Fattoresaimon/I2CEncoderMini/Hardware/BOM/Bill of Materials-EncoderI2C_Mini.xlsx

Description | Designator | Value | Footprint | MouserCode | PartNumber
Capacitor | C1 | 100n | C0402 | 603-CC402KRX5R8BB104 | GRM155R61C104KA88D
Capacitor | C2 | 4u7 | C0805 | 603-CC805ZKY5V7BB475 | CC0805ZKY5V7BB475
Capacitor | C3 | 47n | C0402 | 81-GCM155R71E473KA5D | GCM155R71E473KA55D
Capacitor | C4 | 47n | C0402 | 81-GCM155R71E473KA5D | GCM155R71E473KA55D
Ferrite Bead | L1 | 600R@100MHz | L0402 | 963-BK1005HS601-T | BK1005HS601-T
Resistor | R1 | 10k | R0402 | 603-RC0402FR-0710KL | RC0402FR-0710KL
Resistor | R2 | 10k | R0402 | 603-RC0402FR-0710KL | RC0402FR-0710KL
Resistor | R3 | 10k | R0402 | 603-RC0402FR-0710KL | RC0402FR-0710KL
Resistor | R4 | 10k | R0402 | 603-RC0402FR-0710KL | RC0402FR-0710KL
Microcontrollori a 8 bit - MCU 20MHz, 4KB, SOIC8, Ind 125C, Green, T&R | U1 |  | 8S1_L | 579-ATTINY402-SSFR | ATTINY402-SSFR
