Fattoresaimon/I2CEncoderMini/Hardware/STEP/EncoderI2C_Mini.step

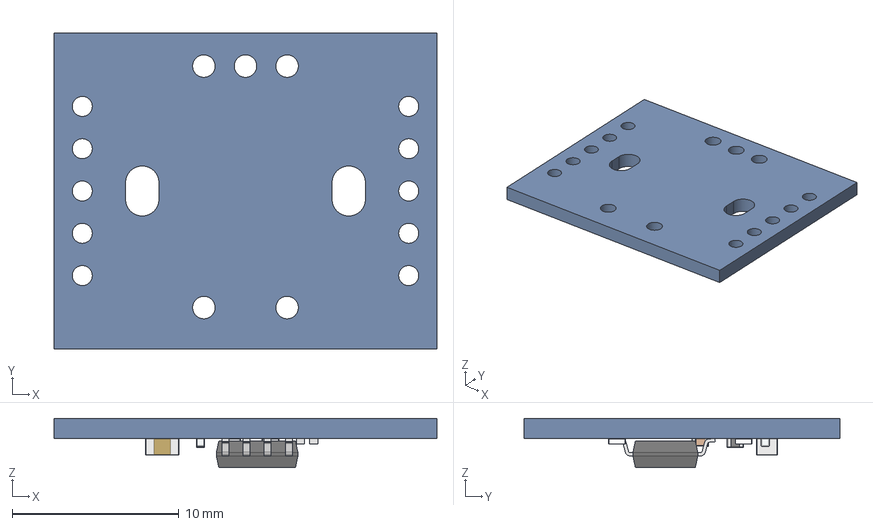
[picture p11: CAD file, 2020-09-24]
Hardware/STEP/EncoderI2C_Mini.step
23.0 x 19.0 x 2.95 mm
User_Library-V0402HD_K_X_F6rper_1
User_Library-V0402HD_Anschl_X_FCsse_1
User_Library-Capacitor_0402 x 3
SOIC-8
User_Library-R_0402 x 4
User_Library-CAPC2013X10
