Fattoresaimon/I2CEncoderMini/(list of files, cad)

Other CAD files:
Hardware/AutoCAD PCB/EncoderI2C_Mini.DWG
