Fattoresaimon/I2CEncoderMini/(threads)

Thread 1 (2020-04-11):

Capacitor discharge resistor

ilium007, 2020-04-11:
Shouldn't there be a small resistor in series with the capacitor and the encoder contacts to prevent the cap short circuit to GND?

Fattoresaimon, 2020-04-11:
Hello, yes you are right!
I know that my filter design it's not very good... That was a quick and dirty solution, my original plan was to don't put any filter and do all in FW. I'm still work on it...

Thread 2 (2020-06-22):

Pin strip spacing.

Hugh3226, 2020-06-22:
It's a real shame the pin spacing is not the same on the V2.1 encoder and the min encoder.

Pin spacing is 19.6mm on the mini and 20.9mm on the v2.1           (estimated from the gerber files)

This makes them almost incompatible.

Regards
Hugh

Thread 3 (2020-10-16):

Mini Encoder not found.

psy1261, 2020-10-16:
I bought several of the mini boards a few months ago but just now got to try them out.  I am running the Change_Address program but can never find the encoder.  I have tried three diffrent boards using a Tinsey 3.2, NodeMCU v2 ESP8266 and a ATmega328P. I have verified my setup each time using an MCP23017 wired for address 0x27, the MCP chip always shows up but never the mini. Any thoughts or suggestions?

Fattoresaimon, 2020-10-16:
Hello,
Did you checked the if there is the pull-up resistor on the I2C bus?
With the default address it works?
Thank you!

psy1261, 2020-10-16:
Yes, as I said I confirmed via two other devices. My apologies, what is the default address? 0x20?

I used 10K pull-up resisters to connect +5v to SCL and +5v to SDA.

I used three diffrent sketches to find i2c devices all three found the other two devices but never the mini encoder. I also ran the Change_Address sketch but it never finds the min-encoder. I am lost.

Paul

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

Fattoresaimon, 2020-10-16:
yes the default address is 0x20
But if the other devices are found the problem are not the pull-up resistors.
check the connection please, and send me a email with the order number.

psy1261, 2020-10-16:
I installed the header pins and hooked up one of the other i2c devices… the two devices are still registering but the mini encoder is not.

Order number was 203512 on July 11 2020.

Any other troubleshooting steps?  Any advantage to changing wire speed? Using the internal pull-ups instead of external? These mini boards would solve several problems I am facing if I can get them to work.

Paul

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

Fattoresaimon, 2020-10-17:
Hello,
Did you tried alle the boards that you bought?
Did you tried the example project?
Did you verified if there is an address conflict in the i2c bus

Try only one board alone without the other device in the same i2c bus.

psy1261, 2020-10-17:
Howdy

I setup an ATmega328P with an Ardweeny programing backpack, external 10K pull-up resisters and only the mini encoder board. I did make one small change to your Change_Address.ino sketch:

void Search(void) {
  uint8_t i, error;
  Serial.println("Scanning....");
  for (i = 0; i < 0x80; i++ )  {
    Wire.beginTransmission(i);
    error = Wire.endTransmission();

    if (error == 0)    {
      Encoder.address = i;
     // if (Encoder.readIDCode() == 0x39) {				// Comment out his line
        Serial.print("I2C Encoder mini found at ");
        Serial.print(Encoder.address);
        Serial.print(" ( ");
        PrintHEX(Encoder.address);
        Serial.print(" )");
        Serial.println(" !!");
      //}											// Comment out his line
    }

  }
}

This allowed be to substitute and i2c OLED display to make sure I have the hardware setup correctly.  With the above change I got the following printout:
**** I2C Encoder Address changer! ****
All the devices must have different address!
Avaiable commands:
  S: for searching the I2C encoder mini
  0xXX or XXX: Address of the target device in hex or decimal

Scanning....
I2C Encoder mini found at 60 ( 0x3C ) !!   <<<< Correctly identifies the i2c OLED display.

At this point, I soldered headers on all the remaining bards. To test I put each new board in circuit, presed the rest button on the Ardweeny/ATmega328P and then entered “S” on the program. I left in the two comments above int the code. I tested all boards with the same results, the mini encoders were not found.  I have to be missing something.

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

psy1261, 2020-10-17:
Well I feel stupid.

I thought the pinout was SCL SDA Open Pin + -
Im fact it is NT SCL SDA + -

It works now. What in the NT pin for?

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

Fattoresaimon, 2020-10-17:
😆
Good that you made to work!
Well there is no NT pin, it's the INT pin.
It's the interrupt output pin, it used to sense when the encoder is rotated without continually pooling the board.
Please check out the datasheet: https://github.com/Fattoresaimon/I2CEncoderMini/blob/master/I2CEncoderMini_v1.2.pdf

psy1261, 2020-10-17:
All working as expected! Thank you for all the help!!!

Closed 2020-10-17.

Thread 4 (2021-01-18):

Using the Atmel Project and loading it into a device under debug immediately bricks the device

rowifi, 2021-01-18:
I've tried two devices, and bricked both. Presumably the project as is must disable the UPDI pin feature in order to use the pin as an interrupt out. Maybe the devices are now functioning as i2c encoders, but I can't check that right now.
If I'm correct, where does that occur in the code? I'd like to prevent it to verify my IDE and programmer is set up correctly.

I didn't think the UPDI could be locked out without setting a fuse, and I didn't think fuses were set by loading and running code in debug.

Fattoresaimon, 2021-01-18:
Hello,
The UPDI pins is used as a GPIO pin in my code, it's configure in the fuse:
`#define f_SYSCFG0  0xF0 //GPIO MODE`
If i remember correctly if you set it as a GPIO, even during the debug, it disable the UPDI and you can't debug.
If the pin is set to GPIO your programmer have to give a 12V pulse in order to revert the pin to the UPDI.
I'm using the pickit4 and it to automatically.
But i remember while i was developing the project, that sometime the ATtiny402 was looking bricked.
The solution was to erase the entire chip plus the UserSignature.
In the Atmel studio you can do like that: Tools -> Device Programming -> memories
Under Device choose the two type of memory.

Thread 5 (2021-01-22):

INT pin not working

nburobotics, 2021-01-22:
I assembled 4 pieces of I2CEncoderMini_V1.1 and uploaded the HEX file directly. I've got everything working except the INT pin.
I'm using the Basic_with_Callbacks sketch. I'm trying to read the configuration and it is:
interrupt config is 255
ID code is 57
version is 17
It seems to me that the INT pin never goes LOW regardless of "i2cEncoderMiniLib::IPUP_ENABLE" or IPUP_DISABLE.
Is there something else around the proper use of the INT?

Fattoresaimon, 2021-01-22:
Hello,
The int pin is also the UPDI pin used for programming.
You have also to flash the fuse bit in order to change the UPDI pin to GPIO.
In atmel studio there is a checkbox where you can select that field.
If you used some DYI programmer probably it will not work, but i'm not sure.
I suggest you to use the pickit4 and use directly Atmel studio by loading the elf file.

nburobotics, 2021-01-26:
Hello,
Thank you Fattoresaimon for your prompt response. I liked very much your encoder solution.
I'm working in Linux and I don't have pickit4... I want to share the following solution which works, It uses avrdude (the same used by Arduino to upload):

for test pruposes (UPDI enabled)
<PATH TO>avrdude -C <PATH TO>avrdude.conf -v -p attiny402 -c jtag2updi -P /dev/ttyUSB0 -Ufuse2:w:0x02:m -Ufuse6:w:0x04:m -Ufuse8:w:0x00:m -Uflash:w:I2CEncoderMini.hex

for "production" purposes (GPIO enabled, UPDI locked)
<PATH TO>avrdude -C <PATH TO>avrdude.conf -v -p attiny402 -c jtag2updi -P /dev/ttyUSB0 -Ufuse2:w:0x02:m -Ufuse5:w:0xc1:m -Ufuse6:w:0x04:m -Ufuse8:w:0x00:m -Ulock:w:0x00:m -Uflash:w:I2CEncoderMini.hex

Fattoresaimon, 2021-01-26:
Hello,
So at the end was the fuse bit right?
Pay attention that in case of UPDI disabled you need to give the 12V pulse to revert back to UPDI.
Thank you for sharing your solution! i think it will be useful for some other user.
Thank you,
Simone

speedcrafter442, 2021-06-22:
Hello,
I tried the suggestion from nburobotics but I can't find the EncoderMini via i2c after the flash.

Result from flash:
C:\avrdude>avrdude -v -p attiny402 -c jtag2updi -P com1 -Ufuse2:w:0x02:m -Ufuse6:w:0x04:m -Ufuse8:w:0x00:m -Uflash:w:I2CEncoderMini.hex

avrdude: Version 6.3, compiled on Feb 17 2016 at 09:25:53
         Copyright (c) 2000-2005 Brian Dean, http://www.bdmicro.com/
         Copyright (c) 2007-2014 Joerg Wunsch

         System wide configuration file is "C:\avrdude\avrdude.conf"

         Using Port                    : com1
         Using Programmer              : jtag2updi
JTAG ICE mkII sign-on message:
Communications protocol version: 1
M_MCU:
  boot-loader FW version:        1
  firmware version:              6.00
  hardware version:              1
S_MCU:
  boot-loader FW version:        1
  firmware version:              6.00
  hardware version:              1
Serial number:                   00:00:00:00:00:00
Device ID:                       JTAGICE mkII
         AVR Part                      : ATtiny402
         Chip Erase delay              : 0 us
         PAGEL                         : P00
         BS2                           : P00
         RESET disposition             : dedicated
         RETRY pulse                   : SCK
         serial program mode           : yes
         parallel program mode         : yes
         Timeout                       : 0
         StabDelay                     : 0
         CmdexeDelay                   : 0
         SyncLoops                     : 0
         ByteDelay                     : 0
         PollIndex                     : 0
         PollValue                     : 0x00
         Memory Detail                 :

                                  Block Poll               Page                       Polled
           Memory Type Mode Delay Size  Indx Paged  Size   Size #Pages MinW  MaxW   ReadBack
           ----------- ---- ----- ----- ---- ------ ------ ---- ------ ----- ----- ---------
           signature      0     0     0    0 no          3    0      0     0     0 0x00 0x00
           prodsig        0     0     0    0 no         61   61      0     0     0 0x00 0x00
           fuses          0     0     0    0 no          9    0      0     0     0 0x00 0x00
           fuse0          0     0     0    0 no          1    0      0     0     0 0x00 0x00
           fuse1          0     0     0    0 no          1    0      0     0     0 0x00 0x00
           fuse2          0     0     0    0 no          1    0      0     0     0 0x00 0x00
           fuse4          0     0     0    0 no          1    0      0     0     0 0x00 0x00
           fuse5          0     0     0    0 no          1    0      0     0     0 0x00 0x00
           fuse6          0     0     0    0 no          1    0      0     0     0 0x00 0x00
           fuse7          0     0     0    0 no          1    0      0     0     0 0x00 0x00
           fuse8          0     0     0    0 no          1    0      0     0     0 0x00 0x00
           lock           0     0     0    0 no          1    0      0     0     0 0x00 0x00
           data           0     0     0    0 no          0    0      0     0     0 0x00 0x00
           usersig        0     0     0    0 no         32   32      0     0     0 0x00 0x00
           flash          0     0     0    0 no       4096   64      0     0     0 0x00 0x00
           eeprom         0     0     0    0 no        128   32      0     0     0 0x00 0x00

         Programmer Type : JTAGMKII_PDI
         Description     : JTAGv2 to UPDI bridge
         M_MCU hardware version: 1
         M_MCU firmware version: 6.00
         S_MCU hardware version: 1
         S_MCU firmware version: 6.00
         Serial number:          00:00:00:00:00:00
         Vtarget         : 5.0 V

avrdude: AVR device initialized and ready to accept instructions

Reading | ################################################## | 100% 0.16s

avrdude: Device signature = 0x1e9227 (probably t402)
avrdude: NOTE: Programmer supports page erase for Xmega devices.
         Each page will be erased before programming it, but no chip erase is performed.
         To disable page erases, specify the -D option; for a chip-erase, use the -e option.
avrdude: reading input file "0x02"
avrdude: writing fuse2 (1 bytes):

Writing | ################################################## | 100% 0.01s

avrdude: 1 bytes of fuse2 written
avrdude: verifying fuse2 memory against 0x02:
avrdude: load data fuse2 data from input file 0x02:
avrdude: input file 0x02 contains 1 bytes
avrdude: reading on-chip fuse2 data:

Reading | ################################################## | 100% 0.01s

avrdude: verifying ...
avrdude: 1 bytes of fuse2 verified
avrdude: reading input file "0x04"
avrdude: writing fuse6 (1 bytes):

Writing | ################################################## | 100% 0.01s

avrdude: 1 bytes of fuse6 written
avrdude: verifying fuse6 memory against 0x04:
avrdude: load data fuse6 data from input file 0x04:
avrdude: input file 0x04 contains 1 bytes
avrdude: reading on-chip fuse6 data:

Reading | ################################################## | 100% 0.01s

avrdude: verifying ...
avrdude: 1 bytes of fuse6 verified
avrdude: reading input file "0x00"
avrdude: writing fuse8 (1 bytes):

Writing | ################################################## | 100% 0.01s

avrdude: 1 bytes of fuse8 written
avrdude: verifying fuse8 memory against 0x00:
avrdude: load data fuse8 data from input file 0x00:
avrdude: input file 0x00 contains 1 bytes
avrdude: reading on-chip fuse8 data:

Reading | ################################################## | 100% 0.01s

avrdude: verifying ...
avrdude: 1 bytes of fuse8 verified
avrdude: reading input file "I2CEncoderMini.hex"
avrdude: input file I2CEncoderMini.hex auto detected as raw binary
avrdude: writing flash (4096 bytes):

Writing | ################################################## | 100% 2.05s

avrdude: 4096 bytes of flash written
avrdude: verifying flash memory against I2CEncoderMini.hex:
avrdude: load data flash data from input file I2CEncoderMini.hex:
avrdude: input file I2CEncoderMini.hex auto detected as raw binary
avrdude: input file I2CEncoderMini.hex contains 4096 bytes
avrdude: reading on-chip flash data:

Reading | ################################################## | 100% 1.35s

avrdude: verifying ...
avrdude: 4096 bytes of flash verified

avrdude done.  Thank you.
