Fattoresaimon/I2CEncoderMini/Hardware/EncoderI2C_Mini.PDF

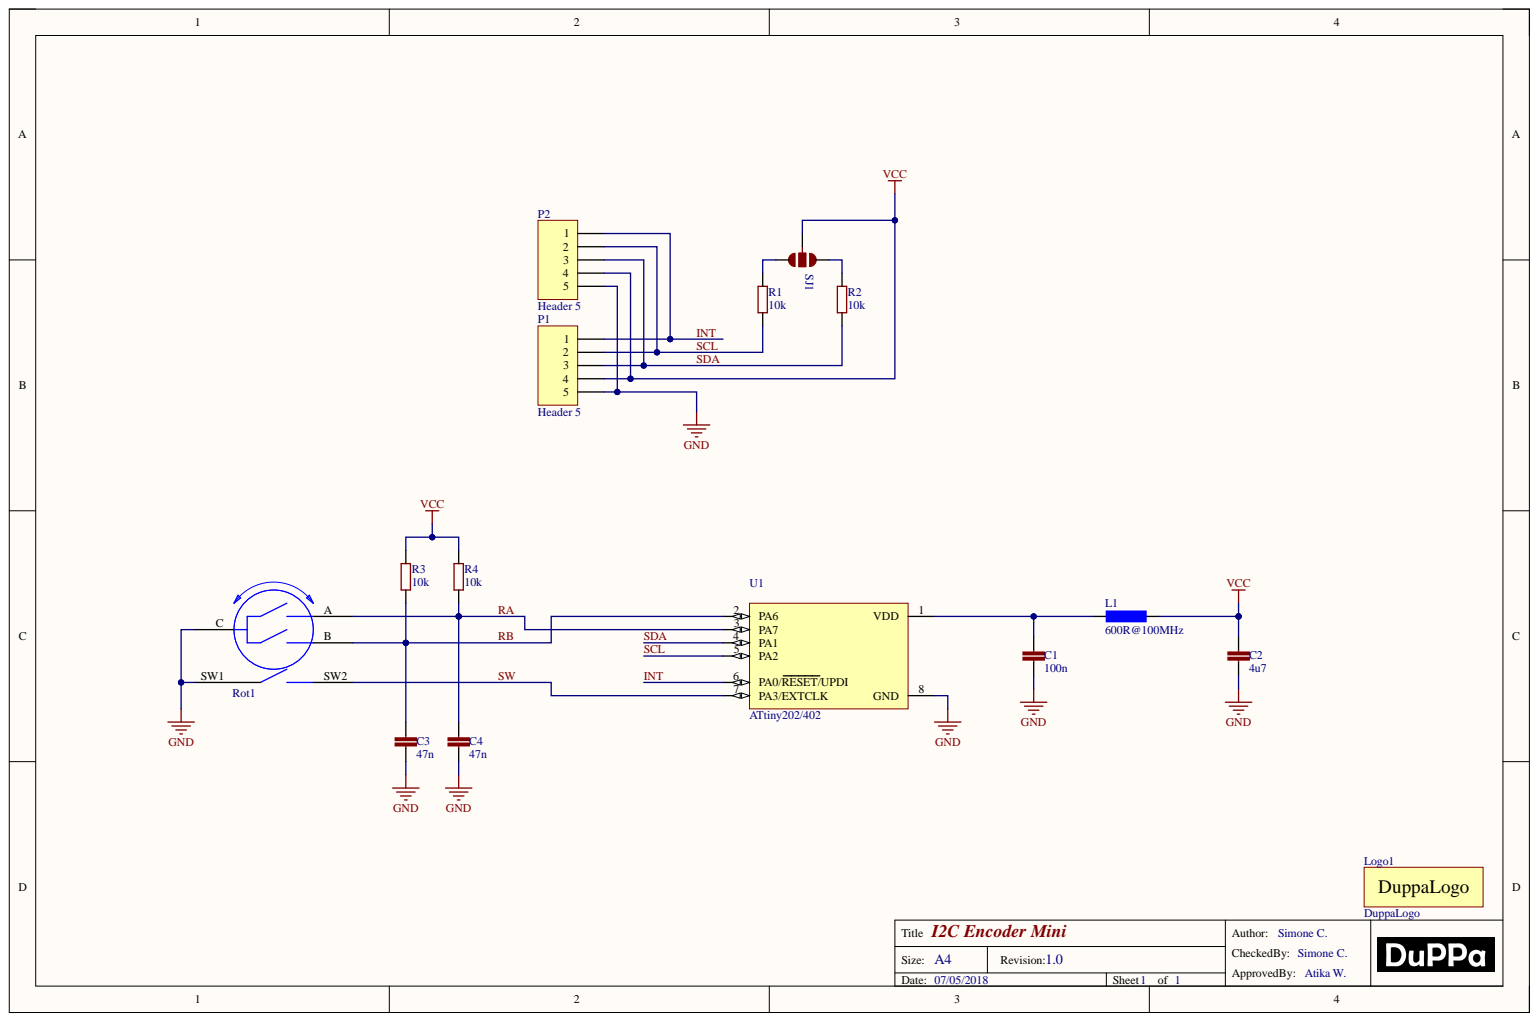
[picture p12: page 1]

SCL
SDA

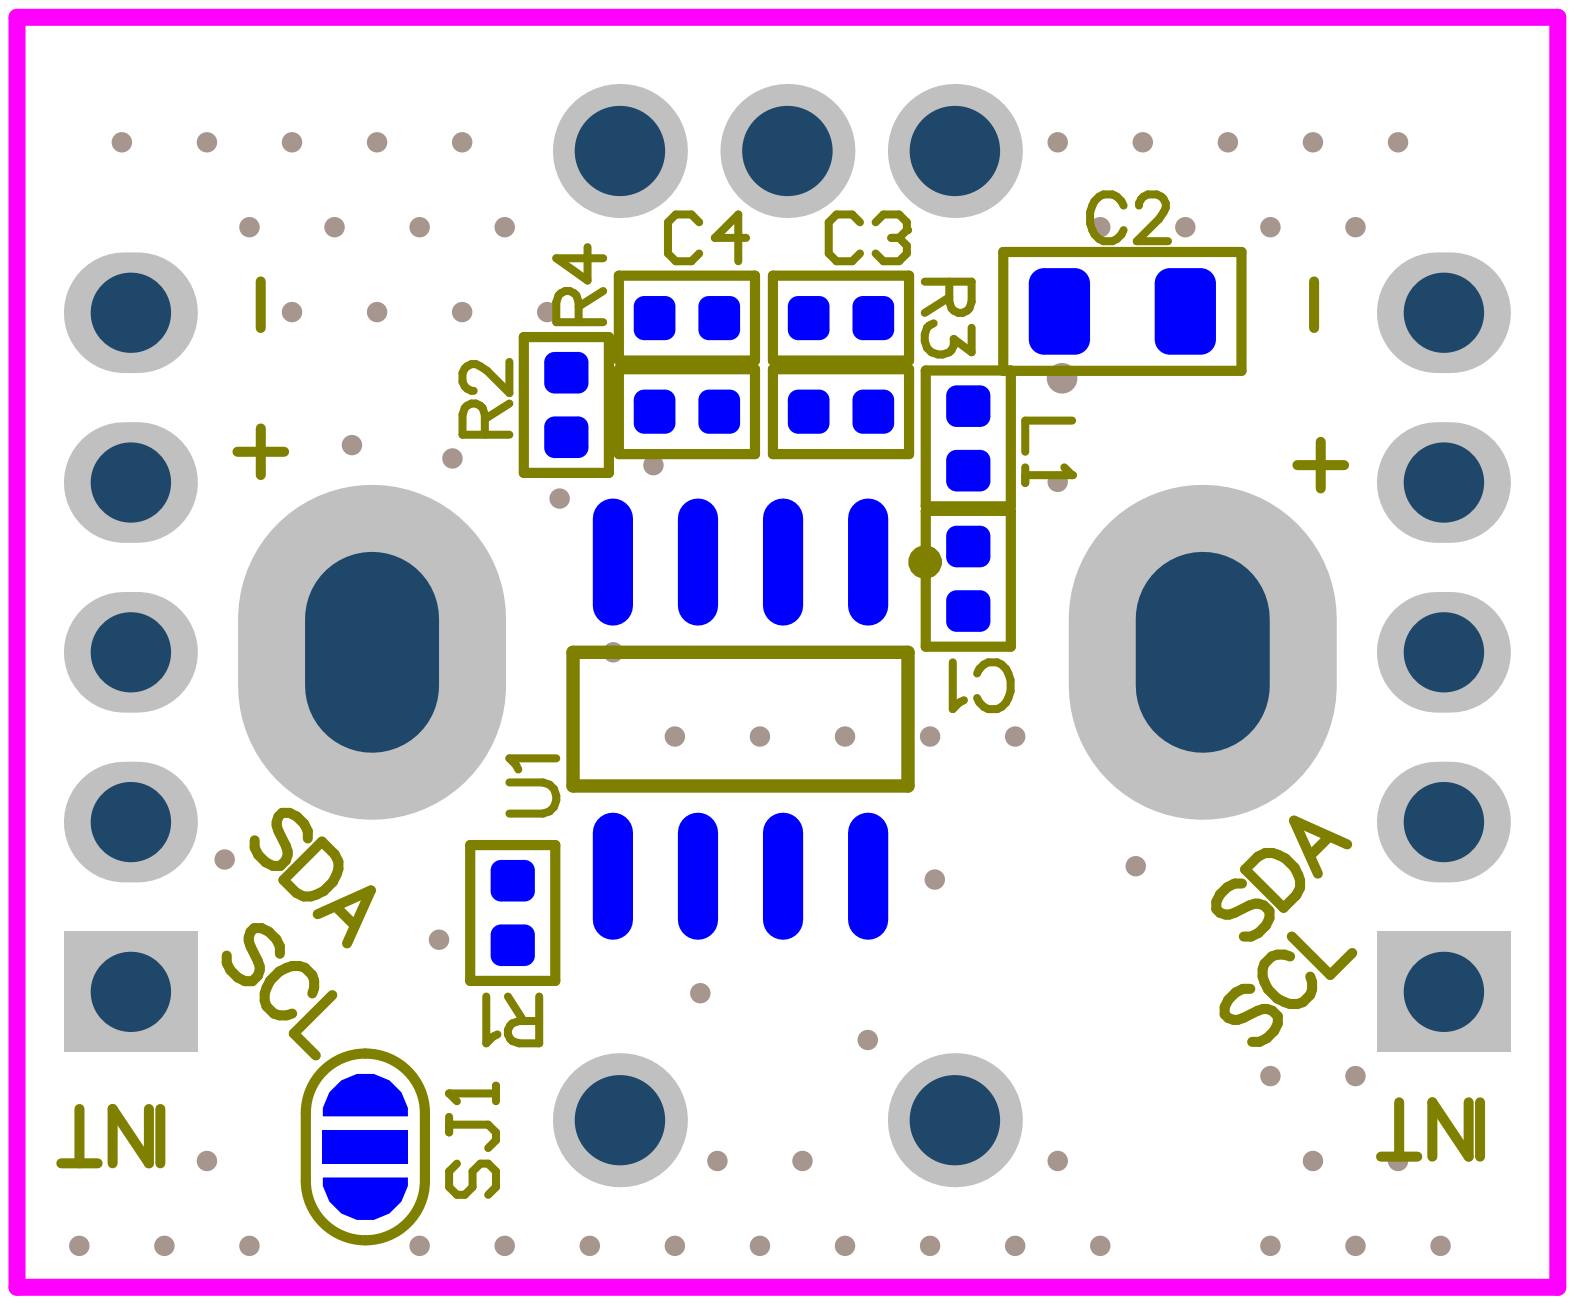
[picture p13: page 2]

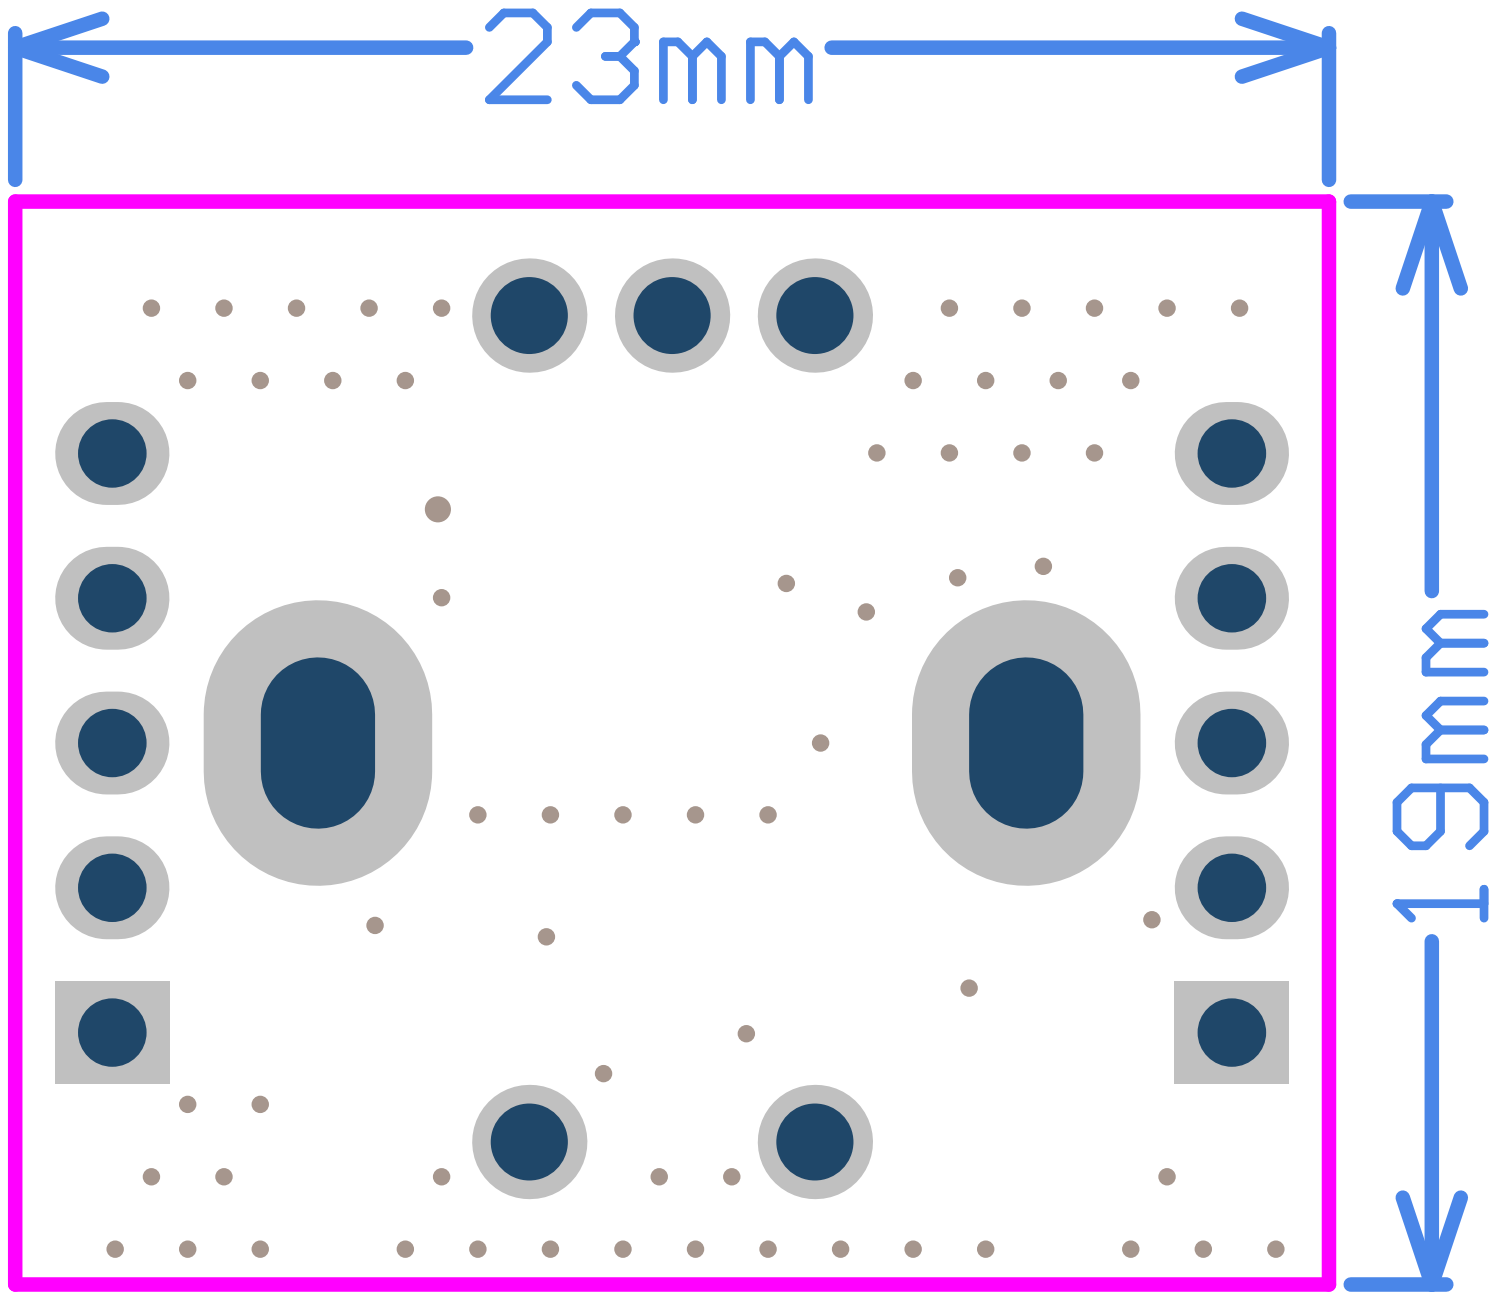
[picture p14: page 3]

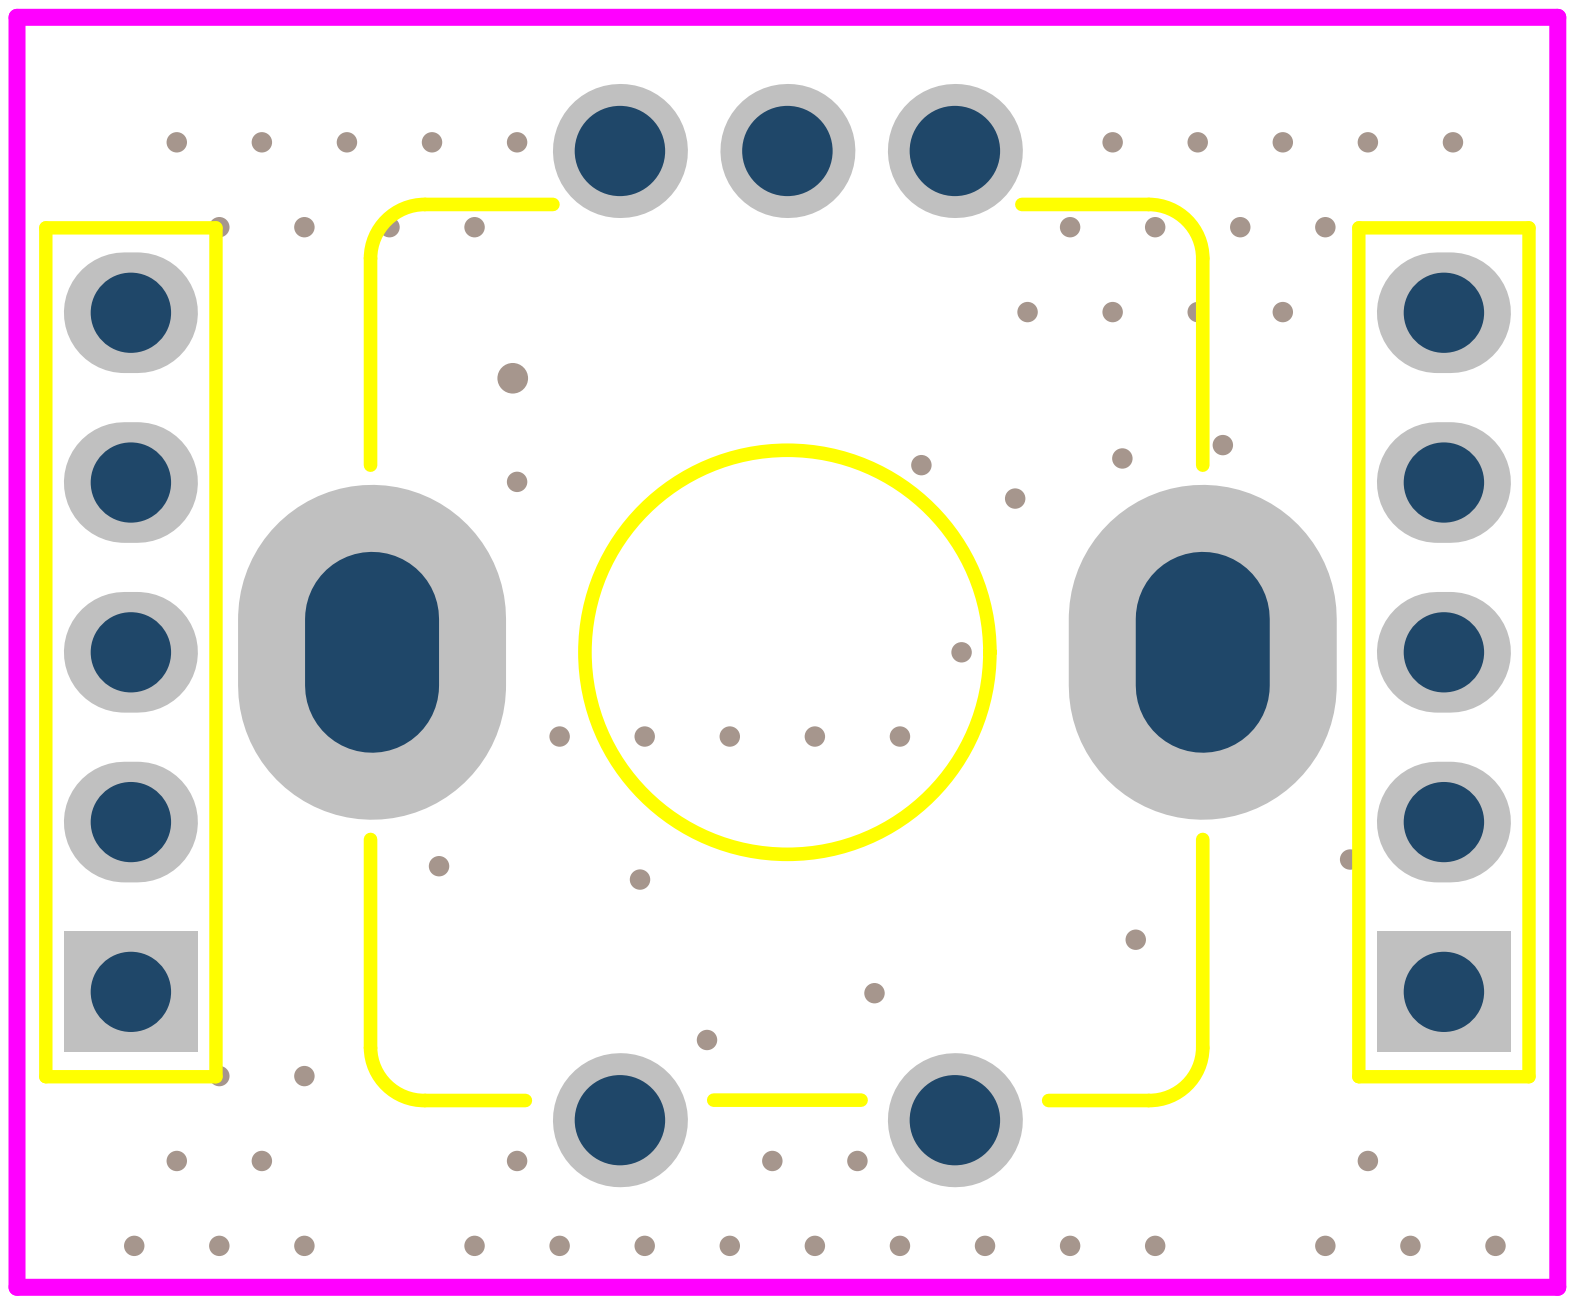
[picture p15: page 4]
