Fattoresaimon/I2CEncoderMini/Firmware/AtmelStudio/I2CEncoderMini/src/driver_init.c

/**
 * \file
 *
 * \brief Driver initialization.
 *
 (c) 2018 Microchip Technology Inc. and its subsidiaries.

    Subject to your compliance with these terms,you may use this software and
    any derivatives exclusively with Microchip products.It is your responsibility
    to comply with third party license terms applicable to your use of third party
    software (including open source software) that may accompany Microchip software.

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
    IN NO EVENT WILL MICROCHIP BE LIABLE FOR ANY INDIRECT, SPECIAL, PUNITIVE,
    INCIDENTAL OR CONSEQUENTIAL LOSS, DAMAGE, COST OR EXPENSE OF ANY KIND
    WHATSOEVER RELATED TO THE SOFTWARE, HOWEVER CAUSED, EVEN IF MICROCHIP HAS
    BEEN ADVISED OF THE POSSIBILITY OR THE DAMAGES ARE FORESEEABLE. TO THE
    FULLEST EXTENT ALLOWED BY LAW, MICROCHIP'S TOTAL LIABILITY ON ALL CLAIMS IN
    ANY WAY RELATED TO THIS SOFTWARE WILL NOT EXCEED THE AMOUNT OF FEES, IF ANY,
    THAT YOU HAVE PAID DIRECTLY TO MICROCHIP FOR THIS SOFTWARE.
 *
 */

/*
 * Code generated by START.
 *
 * This file will be overwritten when reconfiguring your START project.
 * Please copy examples or other code you want to keep to a separate file
 * to avoid losing it when reconfiguring.
 */

#include "driver_init.h"
#include <system.h>

void TIMER_0_initialization(void)
{

	TIMER_0_init();
}

void TIMER_1_initialization(void)
{

	TIMER_1_init();
}

void EVENT_SYSTEM_0_initialization(void)
{

	EVENT_SYSTEM_0_init();
}

/* Initialize registers */
void FLASH_0_initialization(void)
{
	FLASH_0_init();
}

/* configure pins and initialize registers */
void I2C_initialization(void)
{

	SCL_set_dir(
	    // <y> Pin direction
	    // <id> pad_dir
	    // <PORT_DIR_OFF"> Off
	    // <PORT_DIR_IN"> In
	    // <PORT_DIR_OUT"> Out
	    PORT_DIR_OUT);

	SCL_set_level(
	    // <y> Initial level
	    // <id> pad_initial_level
	    // <false"> Low
	    // <true"> High
	    false);

	SCL_set_pull_mode(
	    // <y> Pull configuration
	    // <id> pad_pull_config
	    // <PORT_PULL_OFF"> Off
	    // <PORT_PULL_UP"> Pull-up
	    PORT_PULL_OFF);

	SCL_set_inverted(
	    // <y> Invert I/O on pin
	    // <id> pad_invert
	    // <false"> Not inverted
	    // <true"> Inverted
	    false);

	SCL_set_isc(
	    // <y> Pin Input/Sense Configuration
	    // <id> pad_isc
	    // <PORT_ISC_INTDISABLE_gc"> Interrupt disabled but input buffer enabled
	    // <PORT_ISC_BOTHEDGES_gc"> Sense Both Edges
	    // <PORT_ISC_RISING_gc"> Sense Rising Edge
	    // <PORT_ISC_FALLING_gc"> Sense Falling Edge
	    // <PORT_ISC_INPUT_DISABLE_gc"> Digital Input Buffer disabled
	    // <PORT_ISC_LEVEL_gc"> Sense low Level
	    PORT_ISC_INTDISABLE_gc);

	SDA_set_dir(
	    // <y> Pin direction
	    // <id> pad_dir
	    // <PORT_DIR_OFF"> Off
	    // <PORT_DIR_IN"> In
	    // <PORT_DIR_OUT"> Out
	    PORT_DIR_OUT);

	SDA_set_level(
	    // <y> Initial level
	    // <id> pad_initial_level
	    // <false"> Low
	    // <true"> High
	    false);

	SDA_set_pull_mode(
	    // <y> Pull configuration
	    // <id> pad_pull_config
	    // <PORT_PULL_OFF"> Off
	    // <PORT_PULL_UP"> Pull-up
	    PORT_PULL_OFF);

	SDA_set_inverted(
	    // <y> Invert I/O on pin
	    // <id> pad_invert
	    // <false"> Not inverted
	    // <true"> Inverted
	    false);

	SDA_set_isc(
	    // <y> Pin Input/Sense Configuration
	    // <id> pad_isc
	    // <PORT_ISC_INTDISABLE_gc"> Interrupt disabled but input buffer enabled
	    // <PORT_ISC_BOTHEDGES_gc"> Sense Both Edges
	    // <PORT_ISC_RISING_gc"> Sense Rising Edge
	    // <PORT_ISC_FALLING_gc"> Sense Falling Edge
	    // <PORT_ISC_INPUT_DISABLE_gc"> Digital Input Buffer disabled
	    // <PORT_ISC_LEVEL_gc"> Sense low Level
	    PORT_ISC_INTDISABLE_gc);

	I2C_init();
}

/**
 * \brief System initialization
 */
void system_init()
{
	mcu_init();

	/* PORT setting on PA0 */

	INT_set_dir(
	    // <y> Pin direction
	    // <id> pad_dir
	    // <PORT_DIR_OFF"> Off
	    // <PORT_DIR_IN"> In
	    // <PORT_DIR_OUT"> Out
	    PORT_DIR_IN);

	INT_set_level(
	    // <y> Initial level
	    // <id> pad_initial_level
	    // <false"> Low
	    // <true"> High
	    true);

	INT_set_pull_mode(
	    // <y> Pull configuration
	    // <id> pad_pull_config
	    // <PORT_PULL_OFF"> Off
	    // <PORT_PULL_UP"> Pull-up
	    PORT_PULL_OFF);

	INT_set_inverted(
	    // <y> Invert I/O on pin
	    // <id> pad_invert
	    // <false"> Not inverted
	    // <true"> Inverted
	    false);

	INT_set_isc(
	    // <y> Pin Input/Sense Configuration
	    // <id> pad_isc
	    // <PORT_ISC_INTDISABLE_gc"> Interrupt disabled but input buffer enabled
	    // <PORT_ISC_BOTHEDGES_gc"> Sense Both Edges
	    // <PORT_ISC_RISING_gc"> Sense Rising Edge
	    // <PORT_ISC_FALLING_gc"> Sense Falling Edge
	    // <PORT_ISC_INPUT_DISABLE_gc"> Digital Input Buffer disabled
	    // <PORT_ISC_LEVEL_gc"> Sense low Level
	    PORT_ISC_INTDISABLE_gc);

	/* PORT setting on PA3 */

	SW_set_dir(
	    // <y> Pin direction
	    // <id> pad_dir
	    // <PORT_DIR_OFF"> Off
	    // <PORT_DIR_IN"> In
	    // <PORT_DIR_OUT"> Out
	    PORT_DIR_IN);

	SW_set_level(
	    // <y> Initial level
	    // <id> pad_initial_level
	    // <false"> Low
	    // <true"> High
	    false);

	SW_set_pull_mode(
	    // <y> Pull configuration
	    // <id> pad_pull_config
	    // <PORT_PULL_OFF"> Off
	    // <PORT_PULL_UP"> Pull-up
	    PORT_PULL_UP);

	SW_set_inverted(
	    // <y> Invert I/O on pin
	    // <id> pad_invert
	    // <false"> Not inverted
	    // <true"> Inverted
	    false);

	SW_set_isc(
	    // <y> Pin Input/Sense Configuration
	    // <id> pad_isc
	    // <PORT_ISC_INTDISABLE_gc"> Interrupt disabled but input buffer enabled
	    // <PORT_ISC_BOTHEDGES_gc"> Sense Both Edges
	    // <PORT_ISC_RISING_gc"> Sense Rising Edge
	    // <PORT_ISC_FALLING_gc"> Sense Falling Edge
	    // <PORT_ISC_INPUT_DISABLE_gc"> Digital Input Buffer disabled
	    // <PORT_ISC_LEVEL_gc"> Sense low Level
	    PORT_ISC_INTDISABLE_gc);

	/* PORT setting on PA6 */

	RB_set_dir(
	    // <y> Pin direction
	    // <id> pad_dir
	    // <PORT_DIR_OFF"> Off
	    // <PORT_DIR_IN"> In
	    // <PORT_DIR_OUT"> Out
	    PORT_DIR_IN);

	RB_set_level(
	    // <y> Initial level
	    // <id> pad_initial_level
	    // <false"> Low
	    // <true"> High
	    false);

	RB_set_pull_mode(
	    // <y> Pull configuration
	    // <id> pad_pull_config
	    // <PORT_PULL_OFF"> Off
	    // <PORT_PULL_UP"> Pull-up
	    PORT_PULL_UP);

	RB_set_inverted(
	    // <y> Invert I/O on pin
	    // <id> pad_invert
	    // <false"> Not inverted
	    // <true"> Inverted
	    false);

	RB_set_isc(
	    // <y> Pin Input/Sense Configuration
	    // <id> pad_isc
	    // <PORT_ISC_INTDISABLE_gc"> Interrupt disabled but input buffer enabled
	    // <PORT_ISC_BOTHEDGES_gc"> Sense Both Edges
	    // <PORT_ISC_RISING_gc"> Sense Rising Edge
	    // <PORT_ISC_FALLING_gc"> Sense Falling Edge
	    // <PORT_ISC_INPUT_DISABLE_gc"> Digital Input Buffer disabled
	    // <PORT_ISC_LEVEL_gc"> Sense low Level
	    PORT_ISC_BOTHEDGES_gc);

	/* PORT setting on PA7 */

	RA_set_dir(
	    // <y> Pin direction
	    // <id> pad_dir
	    // <PORT_DIR_OFF"> Off
	    // <PORT_DIR_IN"> In
	    // <PORT_DIR_OUT"> Out
	    PORT_DIR_IN);

	RA_set_level(
	    // <y> Initial level
	    // <id> pad_initial_level
	    // <false"> Low
	    // <true"> High
	    false);

	RA_set_pull_mode(
	    // <y> Pull configuration
	    // <id> pad_pull_config
	    // <PORT_PULL_OFF"> Off
	    // <PORT_PULL_UP"> Pull-up
	    PORT_PULL_UP);

	RA_set_inverted(
	    // <y> Invert I/O on pin
	    // <id> pad_invert
	    // <false"> Not inverted
	    // <true"> Inverted
	    false);

	RA_set_isc(
	    // <y> Pin Input/Sense Configuration
	    // <id> pad_isc
	    // <PORT_ISC_INTDISABLE_gc"> Interrupt disabled but input buffer enabled
	    // <PORT_ISC_BOTHEDGES_gc"> Sense Both Edges
	    // <PORT_ISC_RISING_gc"> Sense Rising Edge
	    // <PORT_ISC_FALLING_gc"> Sense Falling Edge
	    // <PORT_ISC_INPUT_DISABLE_gc"> Digital Input Buffer disabled
	    // <PORT_ISC_LEVEL_gc"> Sense low Level
	    PORT_ISC_BOTHEDGES_gc);

	CLKCTRL_init();

	WDT_init();

	TIMER_0_initialization();

	TIMER_1_initialization();

	EVENT_SYSTEM_0_initialization();

	FLASH_0_initialization();

	CPUINT_init();

	SLPCTRL_init();

	I2C_initialization();

	BOD_init();
}
