Fattoresaimon/I2CEncoderMini/Firmware/AtmelStudio/I2CEncoderMini/include/atmel_start_pins.h

/*
 * Code generated from START.
 *
 * This file will be overwritten when reconfiguring your START project.
 * Please copy examples or other code you want to keep to a separate file
 * to avoid losing it when reconfiguring.
 */
#ifndef ATMEL_START_PINS_H_INCLUDED
#define ATMEL_START_PINS_H_INCLUDED

#include <port.h>

/**
 * \brief Set INT pull mode
 *
 * Configure pin to pull up, down or disable pull mode, supported pull
 * modes are defined by device used
 *
 * \param[in] pull_mode Pin pull mode
 */
static inline void INT_set_pull_mode(const enum port_pull_mode pull_mode)
{
	PORTA_set_pin_pull_mode(0, pull_mode);
}

/**
 * \brief Set INT data direction
 *
 * Select if the pin data direction is input, output or disabled.
 * If disabled state is not possible, this function throws an assert.
 *
 * \param[in] direction PORT_DIR_IN  = Data direction in
 *                      PORT_DIR_OUT = Data direction out
 *                      PORT_DIR_OFF = Disables the pin
 *                      (low power state)
 */
static inline void INT_set_dir(const enum port_dir dir)
{
	PORTA_set_pin_dir(0, dir);
}

/**
 * \brief Set INT input/sense configuration
 *
 * Enable/disable INT digital input buffer and pin change interrupt,
 * select pin interrupt edge/level sensing mode
 *
 * \param[in] isc PORT_ISC_INTDISABLE_gc    = Iterrupt disabled but input buffer enabled
 *                PORT_ISC_BOTHEDGES_gc     = Sense Both Edges
 *                PORT_ISC_RISING_gc        = Sense Rising Edge
 *                PORT_ISC_FALLING_gc       = Sense Falling Edge
 *                PORT_ISC_INPUT_DISABLE_gc = Digital Input Buffer disabled
 *                PORT_ISC_LEVEL_gc         = Sense low Level
 */
static inline void INT_set_isc(const PORT_ISC_t isc)
{
	PORTA_pin_set_isc(0, isc);
}

/**
 * \brief Set INT inverted mode
 *
 * Enable or disable inverted I/O on a pin
 *
 * \param[in] inverted true  = I/O on INT is inverted
 *                     false = I/O on INT is not inverted
 */
static inline void INT_set_inverted(const bool inverted)
{
	PORTA_pin_set_inverted(0, inverted);
}

/**
 * \brief Set INT level
 *
 * Sets output level on a pin
 *
 * \param[in] level true  = Pin level set to "high" state
 *                  false = Pin level set to "low" state
 */
static inline void INT_set_level(const bool level)
{
	PORTA_set_pin_level(0, level);
}

/**
 * \brief Toggle output level on INT
 *
 * Toggle the pin level
 */
static inline void INT_toggle_level()
{
	PORTA_toggle_pin_level(0);
}

/**
 * \brief Get level on INT
 *
 * Reads the level on a pin
 */
static inline bool INT_get_level()
{
	return PORTA_get_pin_level(0);
}

/**
 * \brief Set SDA pull mode
 *
 * Configure pin to pull up, down or disable pull mode, supported pull
 * modes are defined by device used
 *
 * \param[in] pull_mode Pin pull mode
 */
static inline void SDA_set_pull_mode(const enum port_pull_mode pull_mode)
{
	PORTA_set_pin_pull_mode(1, pull_mode);
}

/**
 * \brief Set SDA data direction
 *
 * Select if the pin data direction is input, output or disabled.
 * If disabled state is not possible, this function throws an assert.
 *
 * \param[in] direction PORT_DIR_IN  = Data direction in
 *                      PORT_DIR_OUT = Data direction out
 *                      PORT_DIR_OFF = Disables the pin
 *                      (low power state)
 */
static inline void SDA_set_dir(const enum port_dir dir)
{
	PORTA_set_pin_dir(1, dir);
}

/**
 * \brief Set SDA input/sense configuration
 *
 * Enable/disable SDA digital input buffer and pin change interrupt,
 * select pin interrupt edge/level sensing mode
 *
 * \param[in] isc PORT_ISC_INTDISABLE_gc    = Iterrupt disabled but input buffer enabled
 *                PORT_ISC_BOTHEDGES_gc     = Sense Both Edges
 *                PORT_ISC_RISING_gc        = Sense Rising Edge
 *                PORT_ISC_FALLING_gc       = Sense Falling Edge
 *                PORT_ISC_INPUT_DISABLE_gc = Digital Input Buffer disabled
 *                PORT_ISC_LEVEL_gc         = Sense low Level
 */
static inline void SDA_set_isc(const PORT_ISC_t isc)
{
	PORTA_pin_set_isc(1, isc);
}

/**
 * \brief Set SDA inverted mode
 *
 * Enable or disable inverted I/O on a pin
 *
 * \param[in] inverted true  = I/O on SDA is inverted
 *                     false = I/O on SDA is not inverted
 */
static inline void SDA_set_inverted(const bool inverted)
{
	PORTA_pin_set_inverted(1, inverted);
}

/**
 * \brief Set SDA level
 *
 * Sets output level on a pin
 *
 * \param[in] level true  = Pin level set to "high" state
 *                  false = Pin level set to "low" state
 */
static inline void SDA_set_level(const bool level)
{
	PORTA_set_pin_level(1, level);
}

/**
 * \brief Toggle output level on SDA
 *
 * Toggle the pin level
 */
static inline void SDA_toggle_level()
{
	PORTA_toggle_pin_level(1);
}

/**
 * \brief Get level on SDA
 *
 * Reads the level on a pin
 */
static inline bool SDA_get_level()
{
	return PORTA_get_pin_level(1);
}

/**
 * \brief Set SCL pull mode
 *
 * Configure pin to pull up, down or disable pull mode, supported pull
 * modes are defined by device used
 *
 * \param[in] pull_mode Pin pull mode
 */
static inline void SCL_set_pull_mode(const enum port_pull_mode pull_mode)
{
	PORTA_set_pin_pull_mode(2, pull_mode);
}

/**
 * \brief Set SCL data direction
 *
 * Select if the pin data direction is input, output or disabled.
 * If disabled state is not possible, this function throws an assert.
 *
 * \param[in] direction PORT_DIR_IN  = Data direction in
 *                      PORT_DIR_OUT = Data direction out
 *                      PORT_DIR_OFF = Disables the pin
 *                      (low power state)
 */
static inline void SCL_set_dir(const enum port_dir dir)
{
	PORTA_set_pin_dir(2, dir);
}

/**
 * \brief Set SCL input/sense configuration
 *
 * Enable/disable SCL digital input buffer and pin change interrupt,
 * select pin interrupt edge/level sensing mode
 *
 * \param[in] isc PORT_ISC_INTDISABLE_gc    = Iterrupt disabled but input buffer enabled
 *                PORT_ISC_BOTHEDGES_gc     = Sense Both Edges
 *                PORT_ISC_RISING_gc        = Sense Rising Edge
 *                PORT_ISC_FALLING_gc       = Sense Falling Edge
 *                PORT_ISC_INPUT_DISABLE_gc = Digital Input Buffer disabled
 *                PORT_ISC_LEVEL_gc         = Sense low Level
 */
static inline void SCL_set_isc(const PORT_ISC_t isc)
{
	PORTA_pin_set_isc(2, isc);
}

/**
 * \brief Set SCL inverted mode
 *
 * Enable or disable inverted I/O on a pin
 *
 * \param[in] inverted true  = I/O on SCL is inverted
 *                     false = I/O on SCL is not inverted
 */
static inline void SCL_set_inverted(const bool inverted)
{
	PORTA_pin_set_inverted(2, inverted);
}

/**
 * \brief Set SCL level
 *
 * Sets output level on a pin
 *
 * \param[in] level true  = Pin level set to "high" state
 *                  false = Pin level set to "low" state
 */
static inline void SCL_set_level(const bool level)
{
	PORTA_set_pin_level(2, level);
}

/**
 * \brief Toggle output level on SCL
 *
 * Toggle the pin level
 */
static inline void SCL_toggle_level()
{
	PORTA_toggle_pin_level(2);
}

/**
 * \brief Get level on SCL
 *
 * Reads the level on a pin
 */
static inline bool SCL_get_level()
{
	return PORTA_get_pin_level(2);
}

/**
 * \brief Set SW pull mode
 *
 * Configure pin to pull up, down or disable pull mode, supported pull
 * modes are defined by device used
 *
 * \param[in] pull_mode Pin pull mode
 */
static inline void SW_set_pull_mode(const enum port_pull_mode pull_mode)
{
	PORTA_set_pin_pull_mode(3, pull_mode);
}

/**
 * \brief Set SW data direction
 *
 * Select if the pin data direction is input, output or disabled.
 * If disabled state is not possible, this function throws an assert.
 *
 * \param[in] direction PORT_DIR_IN  = Data direction in
 *                      PORT_DIR_OUT = Data direction out
 *                      PORT_DIR_OFF = Disables the pin
 *                      (low power state)
 */
static inline void SW_set_dir(const enum port_dir dir)
{
	PORTA_set_pin_dir(3, dir);
}

/**
 * \brief Set SW input/sense configuration
 *
 * Enable/disable SW digital input buffer and pin change interrupt,
 * select pin interrupt edge/level sensing mode
 *
 * \param[in] isc PORT_ISC_INTDISABLE_gc    = Iterrupt disabled but input buffer enabled
 *                PORT_ISC_BOTHEDGES_gc     = Sense Both Edges
 *                PORT_ISC_RISING_gc        = Sense Rising Edge
 *                PORT_ISC_FALLING_gc       = Sense Falling Edge
 *                PORT_ISC_INPUT_DISABLE_gc = Digital Input Buffer disabled
 *                PORT_ISC_LEVEL_gc         = Sense low Level
 */
static inline void SW_set_isc(const PORT_ISC_t isc)
{
	PORTA_pin_set_isc(3, isc);
}

/**
 * \brief Set SW inverted mode
 *
 * Enable or disable inverted I/O on a pin
 *
 * \param[in] inverted true  = I/O on SW is inverted
 *                     false = I/O on SW is not inverted
 */
static inline void SW_set_inverted(const bool inverted)
{
	PORTA_pin_set_inverted(3, inverted);
}

/**
 * \brief Set SW level
 *
 * Sets output level on a pin
 *
 * \param[in] level true  = Pin level set to "high" state
 *                  false = Pin level set to "low" state
 */
static inline void SW_set_level(const bool level)
{
	PORTA_set_pin_level(3, level);
}

/**
 * \brief Toggle output level on SW
 *
 * Toggle the pin level
 */
static inline void SW_toggle_level()
{
	PORTA_toggle_pin_level(3);
}

/**
 * \brief Get level on SW
 *
 * Reads the level on a pin
 */
static inline bool SW_get_level()
{
	return PORTA_get_pin_level(3);
}

/**
 * \brief Set RB pull mode
 *
 * Configure pin to pull up, down or disable pull mode, supported pull
 * modes are defined by device used
 *
 * \param[in] pull_mode Pin pull mode
 */
static inline void RB_set_pull_mode(const enum port_pull_mode pull_mode)
{
	PORTA_set_pin_pull_mode(6, pull_mode);
}

/**
 * \brief Set RB data direction
 *
 * Select if the pin data direction is input, output or disabled.
 * If disabled state is not possible, this function throws an assert.
 *
 * \param[in] direction PORT_DIR_IN  = Data direction in
 *                      PORT_DIR_OUT = Data direction out
 *                      PORT_DIR_OFF = Disables the pin
 *                      (low power state)
 */
static inline void RB_set_dir(const enum port_dir dir)
{
	PORTA_set_pin_dir(6, dir);
}

/**
 * \brief Set RB input/sense configuration
 *
 * Enable/disable RB digital input buffer and pin change interrupt,
 * select pin interrupt edge/level sensing mode
 *
 * \param[in] isc PORT_ISC_INTDISABLE_gc    = Iterrupt disabled but input buffer enabled
 *                PORT_ISC_BOTHEDGES_gc     = Sense Both Edges
 *                PORT_ISC_RISING_gc        = Sense Rising Edge
 *                PORT_ISC_FALLING_gc       = Sense Falling Edge
 *                PORT_ISC_INPUT_DISABLE_gc = Digital Input Buffer disabled
 *                PORT_ISC_LEVEL_gc         = Sense low Level
 */
static inline void RB_set_isc(const PORT_ISC_t isc)
{
	PORTA_pin_set_isc(6, isc);
}

/**
 * \brief Set RB inverted mode
 *
 * Enable or disable inverted I/O on a pin
 *
 * \param[in] inverted true  = I/O on RB is inverted
 *                     false = I/O on RB is not inverted
 */
static inline void RB_set_inverted(const bool inverted)
{
	PORTA_pin_set_inverted(6, inverted);
}

/**
 * \brief Set RB level
 *
 * Sets output level on a pin
 *
 * \param[in] level true  = Pin level set to "high" state
 *                  false = Pin level set to "low" state
 */
static inline void RB_set_level(const bool level)
{
	PORTA_set_pin_level(6, level);
}

/**
 * \brief Toggle output level on RB
 *
 * Toggle the pin level
 */
static inline void RB_toggle_level()
{
	PORTA_toggle_pin_level(6);
}

/**
 * \brief Get level on RB
 *
 * Reads the level on a pin
 */
static inline bool RB_get_level()
{
	return PORTA_get_pin_level(6);
}

/**
 * \brief Set RA pull mode
 *
 * Configure pin to pull up, down or disable pull mode, supported pull
 * modes are defined by device used
 *
 * \param[in] pull_mode Pin pull mode
 */
static inline void RA_set_pull_mode(const enum port_pull_mode pull_mode)
{
	PORTA_set_pin_pull_mode(7, pull_mode);
}

/**
 * \brief Set RA data direction
 *
 * Select if the pin data direction is input, output or disabled.
 * If disabled state is not possible, this function throws an assert.
 *
 * \param[in] direction PORT_DIR_IN  = Data direction in
 *                      PORT_DIR_OUT = Data direction out
 *                      PORT_DIR_OFF = Disables the pin
 *                      (low power state)
 */
static inline void RA_set_dir(const enum port_dir dir)
{
	PORTA_set_pin_dir(7, dir);
}

/**
 * \brief Set RA input/sense configuration
 *
 * Enable/disable RA digital input buffer and pin change interrupt,
 * select pin interrupt edge/level sensing mode
 *
 * \param[in] isc PORT_ISC_INTDISABLE_gc    = Iterrupt disabled but input buffer enabled
 *                PORT_ISC_BOTHEDGES_gc     = Sense Both Edges
 *                PORT_ISC_RISING_gc        = Sense Rising Edge
 *                PORT_ISC_FALLING_gc       = Sense Falling Edge
 *                PORT_ISC_INPUT_DISABLE_gc = Digital Input Buffer disabled
 *                PORT_ISC_LEVEL_gc         = Sense low Level
 */
static inline void RA_set_isc(const PORT_ISC_t isc)
{
	PORTA_pin_set_isc(7, isc);
}

/**
 * \brief Set RA inverted mode
 *
 * Enable or disable inverted I/O on a pin
 *
 * \param[in] inverted true  = I/O on RA is inverted
 *                     false = I/O on RA is not inverted
 */
static inline void RA_set_inverted(const bool inverted)
{
	PORTA_pin_set_inverted(7, inverted);
}

/**
 * \brief Set RA level
 *
 * Sets output level on a pin
 *
 * \param[in] level true  = Pin level set to "high" state
 *                  false = Pin level set to "low" state
 */
static inline void RA_set_level(const bool level)
{
	PORTA_set_pin_level(7, level);
}

/**
 * \brief Toggle output level on RA
 *
 * Toggle the pin level
 */
static inline void RA_toggle_level()
{
	PORTA_toggle_pin_level(7);
}

/**
 * \brief Get level on RA
 *
 * Reads the level on a pin
 */
static inline bool RA_get_level()
{
	return PORTA_get_pin_level(7);
}

#endif /* ATMEL_START_PINS_H_INCLUDED */
