Fattoresaimon/I2CEncoderMini/(commit log)

2020-08-29 FW update to v1.1
    Solved the issue regard the missing interrupt when the push button is realesed.
    [Encoder.c, i2c_register.h]
2020-09-23 Fixed the PCB thickness
    [EncoderI2C_Mini.DWG, EncoderI2C_Mini.step]
